Atomicbeast101/universal-control-box/3dmodels/MF-MSMF050-2.step

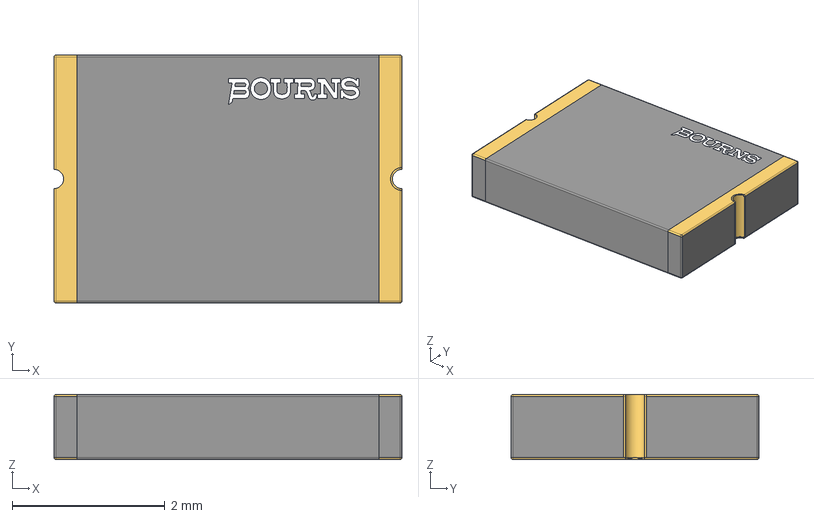
[picture p1: CAD file, 2024-06-03]
3dmodels/MF-MSMF050-2.step
4.55 x 3.24 x 0.851 mm
SDSDS
pIN eXTEND
gOLD
Bourns Logo-LAPTOP-NQA1DCQ3
