Atomicbeast101/universal-control-box/enclosure-model/Display Bracket.stl

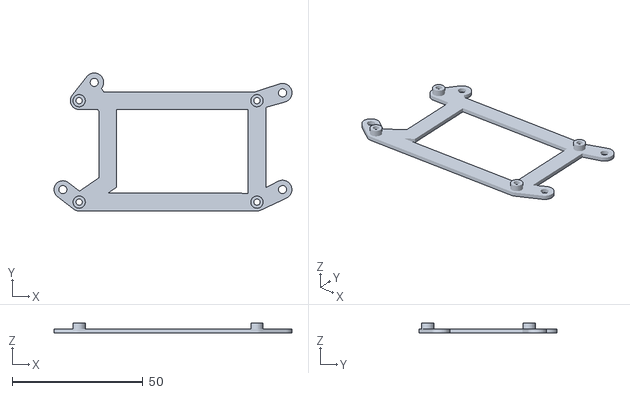
[picture p2: CAD file, 2024-06-03]
enclosure-model/Display Bracket.stl
91.0 x 52.8 x 4.00
