Atomicbeast101/universal-control-box/Universal Control Box.step

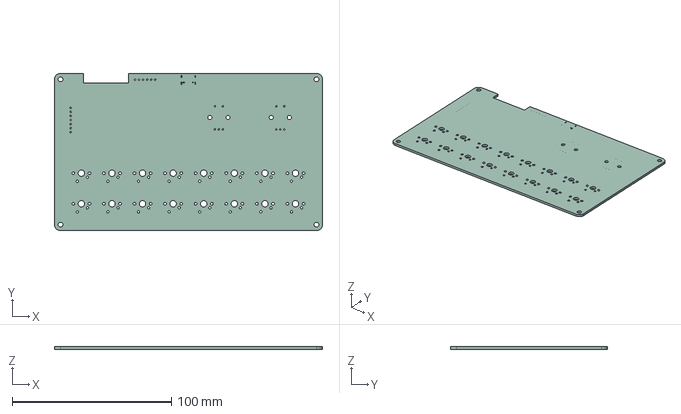
[picture p3: CAD file, 2024-06-03]
Universal Control Box.step
168.2 x 98.8 x 1.61 mm
