Atomicbeast101/universal-control-box/3dmodels/USB_type_C_smd_12p.stp

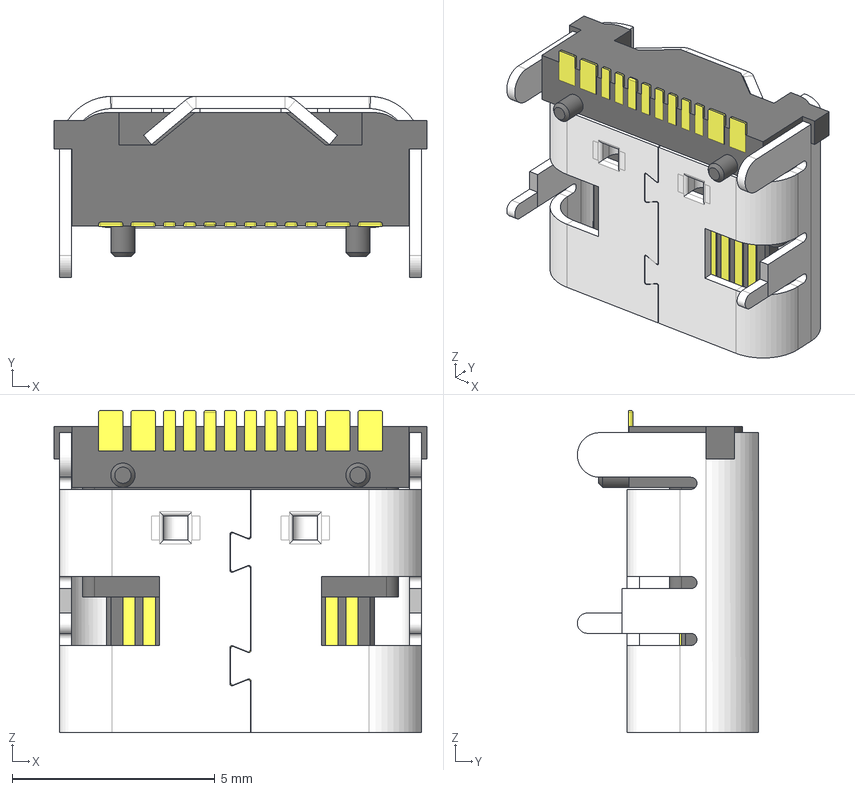
[picture p4: CAD file, 2024-06-03]
3dmodels/USB_type_C_smd_12p.stp
9.20 x 4.47 x 7.95 mm
