Atomicbeast101/universal-control-box/enclosure-model/Top.stl

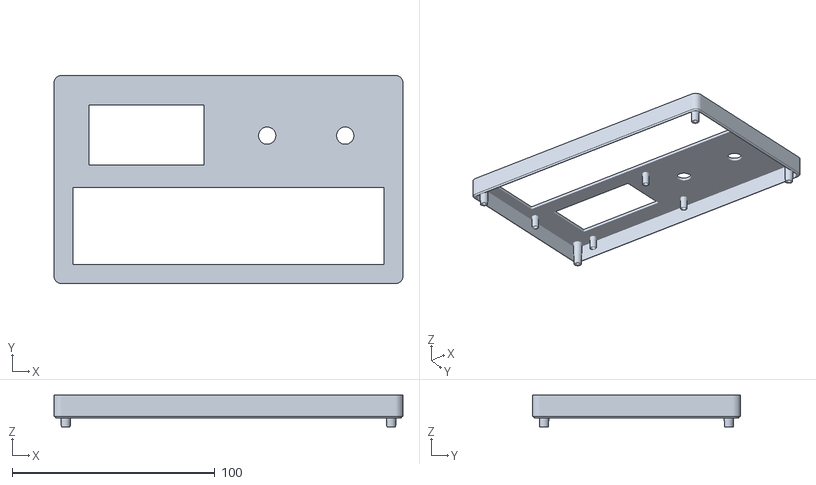
[picture p5: CAD file, 2024-06-03]
enclosure-model/Top.stl
172.2 x 102.8 x 15.7
