Atomicbeast101/universal-control-box/3dmodels/SSD1309_OLED.step

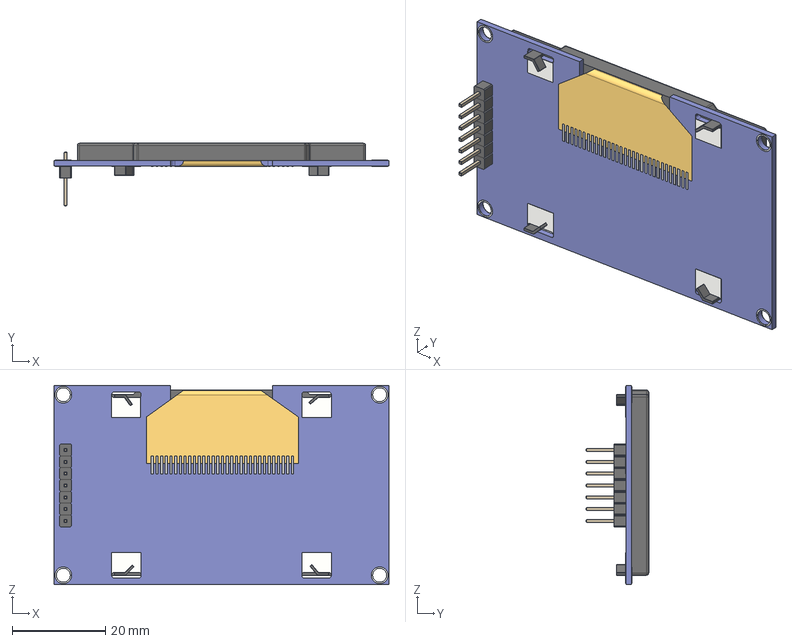
[picture p6: CAD file, 2024-06-03]
3dmodels/SSD1309_OLED.step
72.0 x 13.4 x 42.8 mm
screen
cable
PLS-7 v2
