Atomicbeast101/universal-control-box/enclosure-model/Bottom.stl

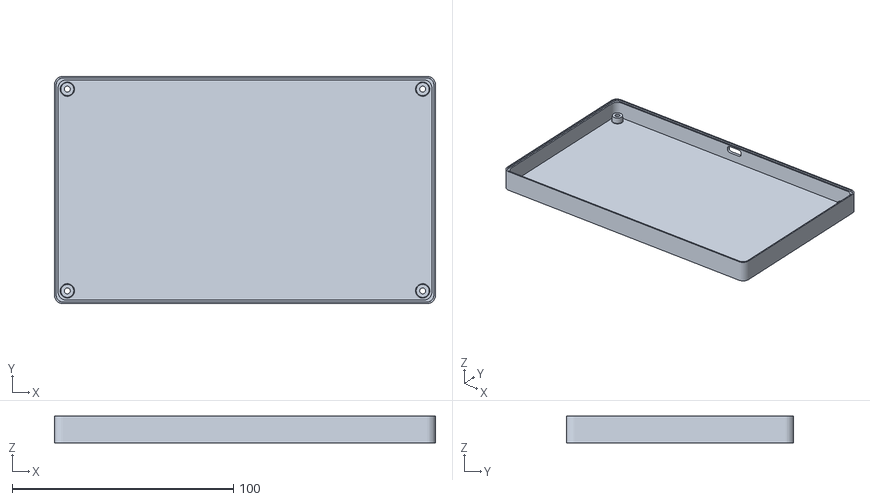
[picture p7: CAD file, 2024-06-03]
enclosure-model/Bottom.stl
172.2 x 102.8 x 12.0
