Atomicbeast101/universal-control-box/3dmodels/WS2812B-2020.stp

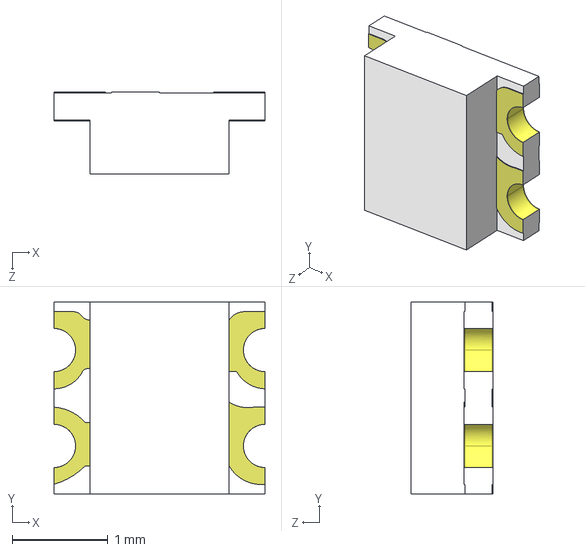
[picture p8: CAD file, 2024-06-03]
3dmodels/WS2812B-2020.stp
2.20 x 2.00 x 0.85 mm
