Atomicbeast101/universal-control-box/3dmodels/TexasInstruments_PFC8575DBR.stp

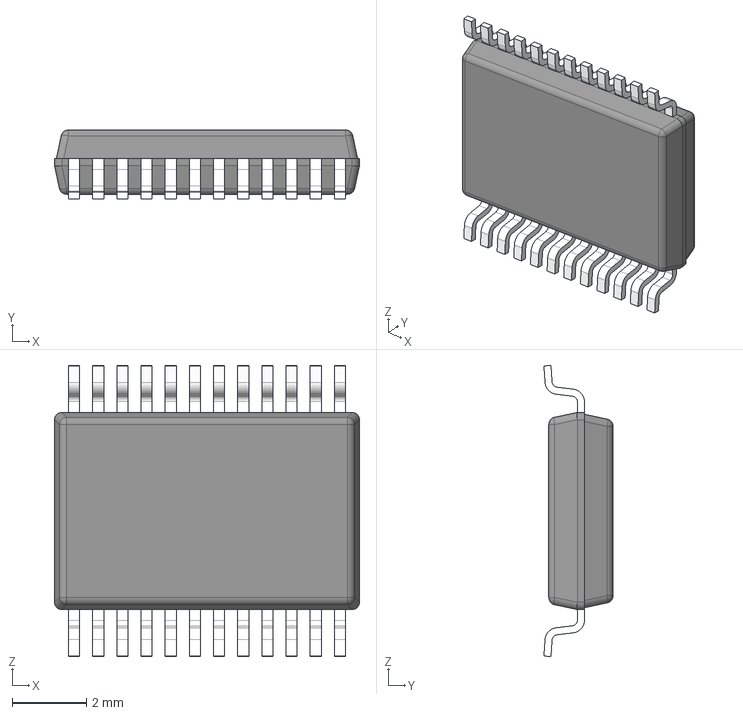
[picture p9: CAD file, 2024-06-03]
3dmodels/TexasInstruments_PFC8575DBR.stp
8.20 x 1.86 x 7.83 mm
BODY_MSA24
LEAD_MSA24 x 24
