Atomicbeast101/universal-control-box/3dmodels/SW_Cherry_MX_PCB.stp

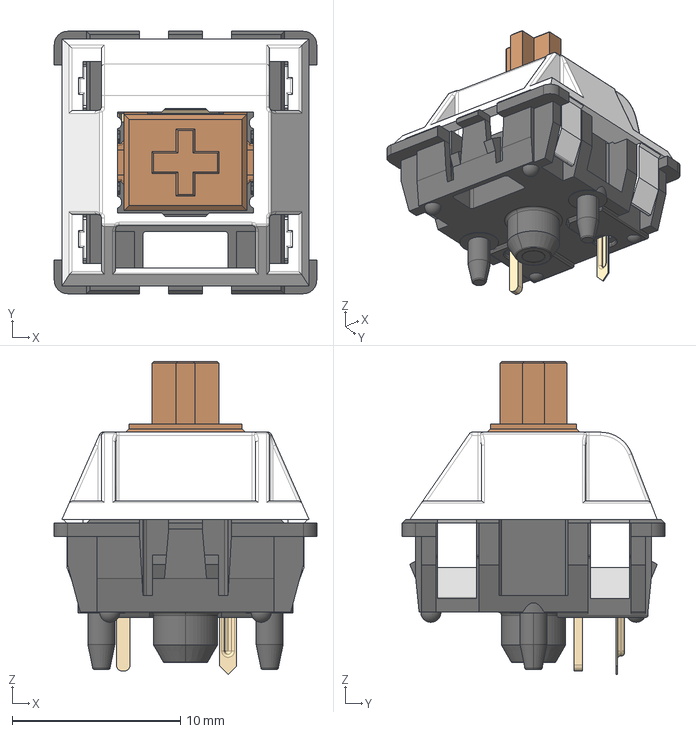
[picture p10: CAD file, 2024-06-03]
3dmodels/SW_Cherry_MX_PCB.stp
15.6 x 15.6 x 18.6 mm
