Atomicbeast101/universal-control-box/3dmodels/Bourns_PEC11H-4025F-S0016.step

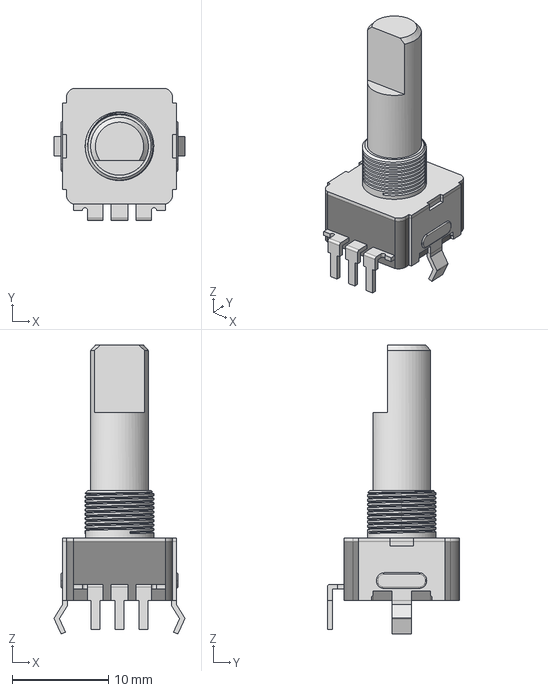
[picture p11: CAD file, 2024-06-03]
3dmodels/Bourns_PEC11H-4025F-S0016.step
13.6 x 13.7 x 30.0 mm
