Atomicbeast101/universal-control-box/Universal Control Box.kicad_pcb

## KiCad design Universal Control Box.kicad_pcb (2024-06-03)

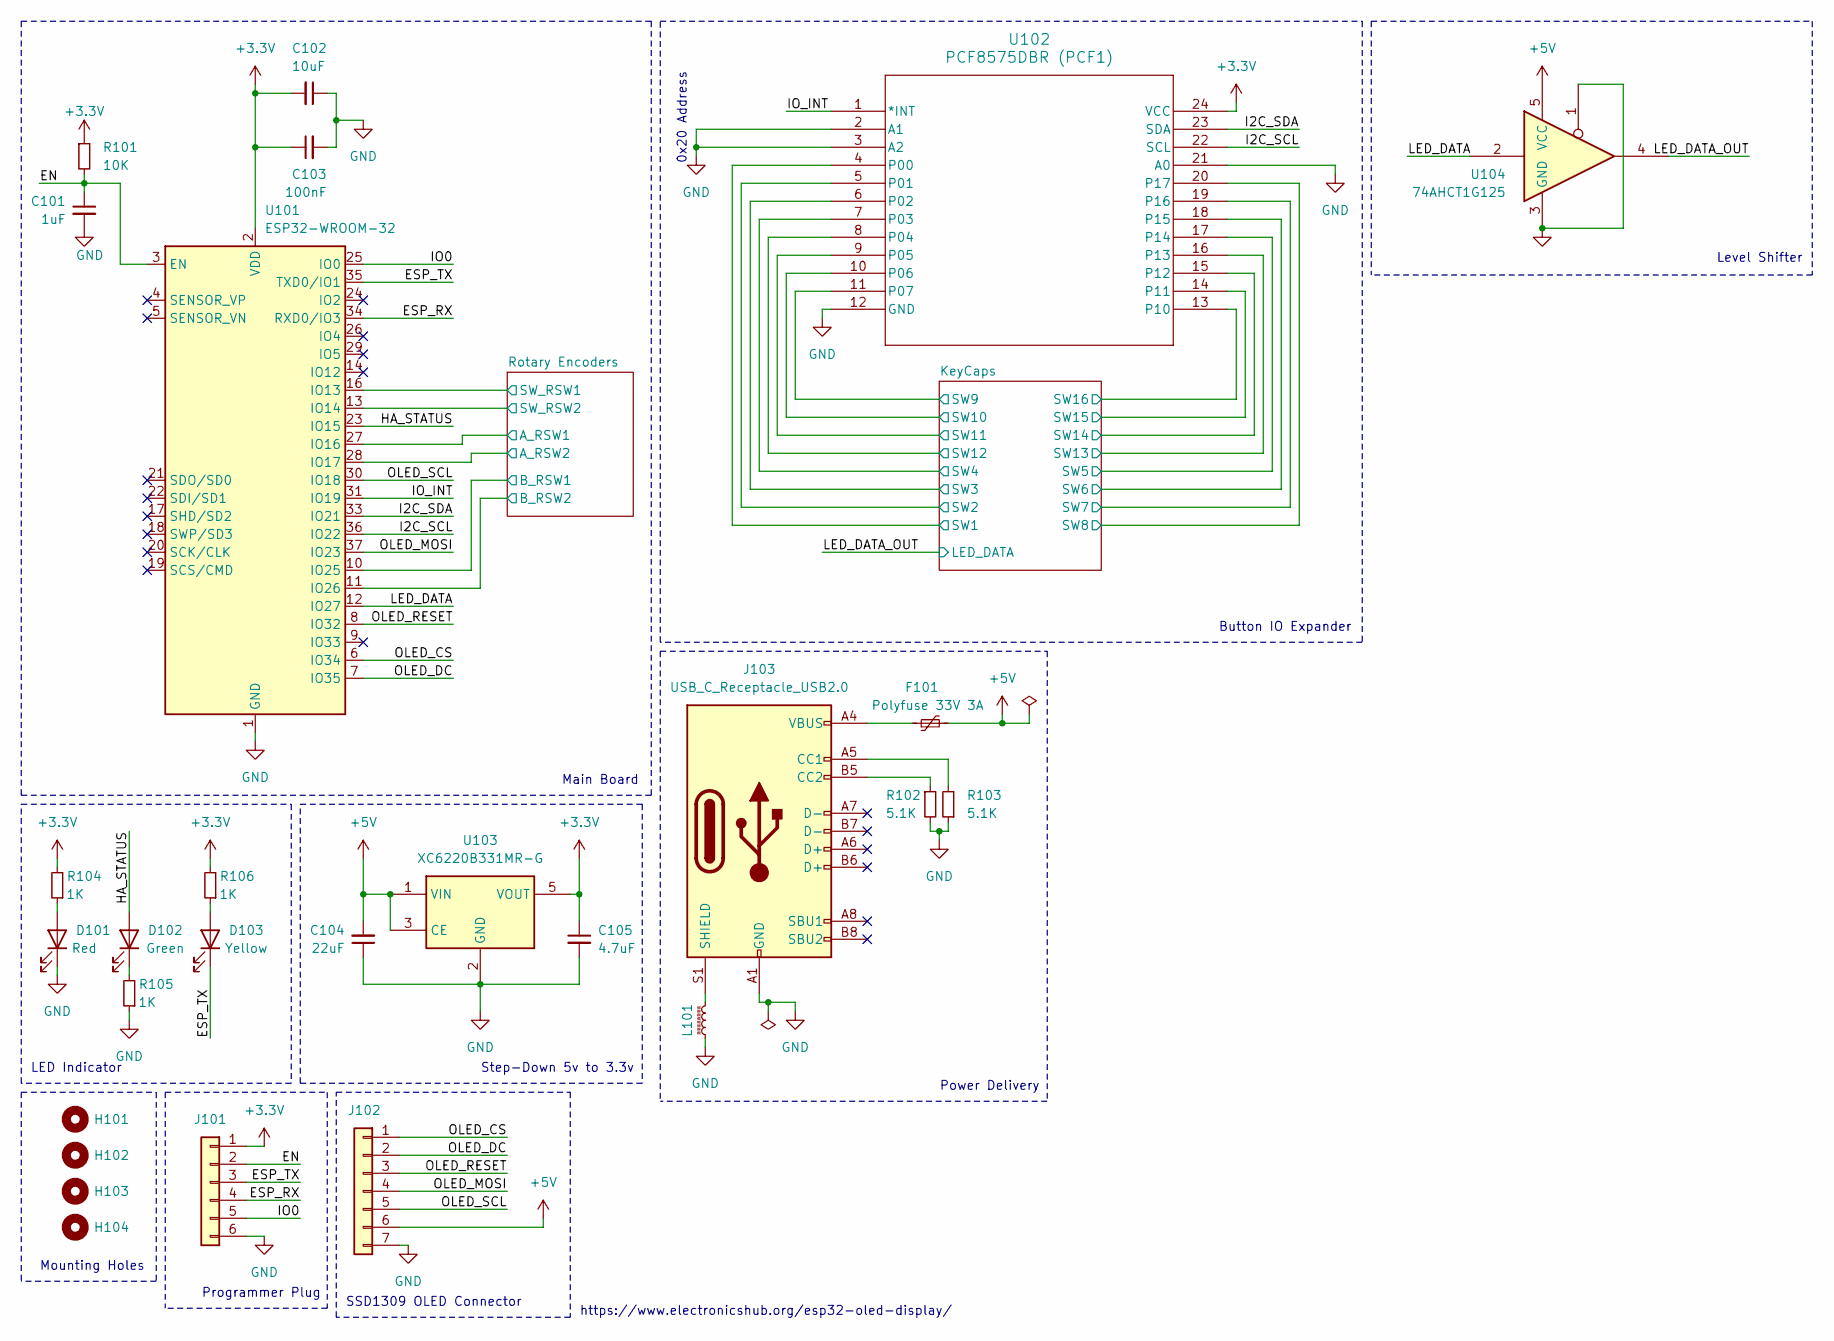
[picture p12: schematic Universal Control Box.kicad_sch]

Parts:
C101: 1uF; C_0603_1608Metric; LCSC C15849
C102: 10uF; C_0603_1608Metric; LCSC C96446
C103: 100nF; C_0603_1608Metric; LCSC C14663
C104: 22uF; C_0603_1608Metric; LCSC C59461
C105: 4.7uF; C_0603_1608Metric; LCSC C19666
D101: Red; LED_0805_2012Metric; LCSC C84256
D102: Green; LED_0805_2012Metric; LCSC C2297
D103: Yellow; LED_0805_2012Metric; LCSC C2296
F101: Polyfuse 33V 3A; Fuse_1812_4532Metric; LCSC C883154
H101, H102, H103, H104: MountingHole; MountingHole_3mm
J101: Conn_01x06; PinSocket_1x06_P2.54mm_Vertical
J102: Conn_01x07; PinSocket_1x07_P2.54mm_Vertical_SSD1309
J103: USB_C_Receptacle_USB2.0; USB_C_Receptable_918-418K2023S40001; LCSC C2982555
L101: L_Ferrite_Small; L_0603_1608Metric; LCSC C62708
R101: 10K; R_0603_1608Metric; LCSC C25804
R102, R103: 5.1K; R_0603_1608Metric; LCSC C25804
R104, R105, R106: 1K; R_0603_1608Metric; LCSC C21190
U101: ESP32-WROOM-32; LCSC C473012
U102: PCF8575DBR (PCF1); TexasInstruments_PCF8575DBR; LCSC C2863388
U103: XC6220B331MR-G; SOT-23-5; LCSC C86534
U104: 74AHCT1G125; SOT-23-5; LCSC C7484

Connections:
+3.3V: C102.2, C103.1, C105.1, J101.1, R101.1, R104.2, R106.2, U101.2 (VDD), U102.24 (VCC), U103.5 (VOUT); also elsewhere on the board
+5V: C104.2, F101.2, J102.6, U103.1 (VIN), U103.3 (CE), U104.5 (VCC); also elsewhere on the board
/EN: C101.1, J101.2, R101.2, U101.3 (EN)
/ESP_RX: J101.4, U101.34 (RXD0/IO3)
/ESP_TX: D103.1 (K), J101.3, U101.35 (TXD0/IO1)
/HA_STATUS: D102.2 (A), U101.23 (IO15)
/I2C_SCL: U101.36 (IO22), U102.22 (SCL)
/I2C_SDA: U101.33 (IO21), U102.23 (SDA)
/IO0: J101.5, U101.25 (IO0)
/IO_INT: U101.31 (IO19), U102.1 (*INT)
/KeyCaps/SW1: U102.4 (P00); also elsewhere on the board
/KeyCaps/SW2: U102.5 (P01); also elsewhere on the board
/KeyCaps/SW3: U102.6 (P02); also elsewhere on the board
/KeyCaps/SW4: U102.7 (P03); also elsewhere on the board
/KeyCaps/SW5: U102.17 (P14); also elsewhere on the board
/KeyCaps/SW6: U102.18 (P15); also elsewhere on the board
/KeyCaps/SW7: U102.19 (P16); also elsewhere on the board
/KeyCaps/SW8: U102.20 (P17); also elsewhere on the board
/KeyCaps/SW9: U102.11 (P07); also elsewhere on the board
/KeyCaps/SW10: U102.10 (P06); also elsewhere on the board
/KeyCaps/SW11: U102.9 (P05); also elsewhere on the board
/KeyCaps/SW12: U102.8 (P04); also elsewhere on the board
/KeyCaps/SW13: U102.16 (P13); also elsewhere on the board
/KeyCaps/SW14: U102.15 (P12); also elsewhere on the board
/KeyCaps/SW15: U102.14 (P11); also elsewhere on the board
/KeyCaps/SW16: U102.13 (P10); also elsewhere on the board
/LED_DATA: U101.12 (IO27), U104.2
/LED_DATA_OUT: U104.4; also elsewhere on the board
/OLED_CS: J102.1, U101.6 (IO34)
/OLED_DC: J102.2, U101.7 (IO35)
/OLED_MOSI: J102.4, U101.37 (IO23)
/OLED_RESET: J102.3, U101.8 (IO32)
/OLED_SCL: J102.5, U101.30 (IO18)
/Rotary Encoders/A_RSW1: U101.27 (IO16); also elsewhere on the board
/Rotary Encoders/A_RSW2: U101.28 (IO17); also elsewhere on the board
/Rotary Encoders/B_RSW1: U101.10 (IO25); also elsewhere on the board
/Rotary Encoders/B_RSW2: U101.11 (IO26); also elsewhere on the board
/Rotary Encoders/SW_RSW1: U101.16 (IO13); also elsewhere on the board
/Rotary Encoders/SW_RSW2: U101.13 (IO14); also elsewhere on the board
GND: C101.2, C102.1, C103.2, C104.1, C105.2, D101.1 (K), J101.6, J102.7, J103.A1 (GND), J103.A12 (GND), J103.B1 (GND), J103.B12 (GND), L101.1, R102.2, R103.1, R105.1, U101.1 (GND), U101.15 (GND), U101.38 (GND), U101.39 (GND), U102.2 (A1), U102.3 (A2), U102.12 (GND), U102.21 (A0), U103.2 (GND), U104.1, U104.3 (GND); also elsewhere on the board
unnamed: D101.2 (A), R104.1
unnamed: D102.1 (K), R105.2
unnamed: D103.2 (A), R106.1
unnamed: F101.1, J103.A4 (VBUS), J103.A9 (VBUS), J103.B4 (VBUS), J103.B9 (VBUS)
unnamed: J103.A5 (CC1), R103.2
unnamed: J103.B5 (CC2), R102.1
unnamed: J103.S1 (SHIELD), L101.2

Notes on the sheet:
Mounting Holes
Power Delivery
Button IO Expander
https://www.electronicshub.org/esp32-oled-display/
LED Indicator
0x20 Address
Programmer Plug
SSD1309 OLED Connector
Step-Down 5v to 3.3v
Level Shifter
Main Board

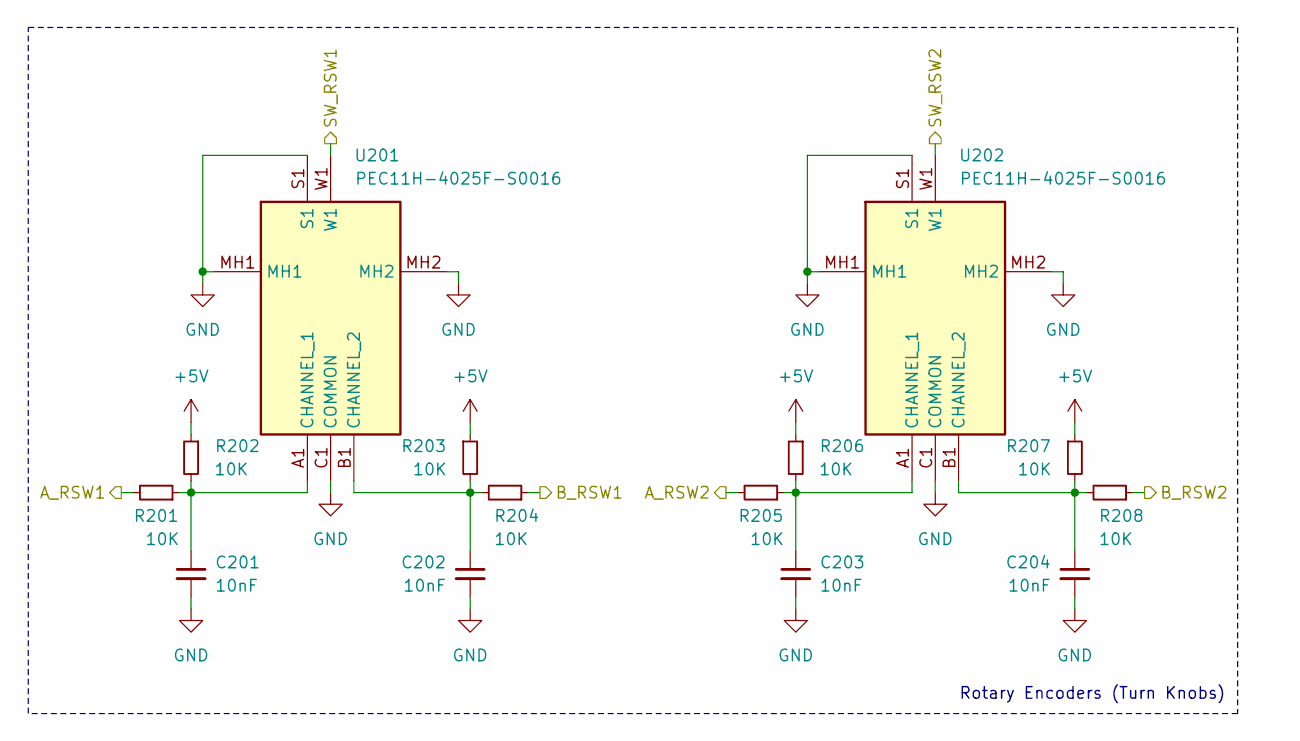
[picture p13: schematic RotaryEncoders.kicad_sch]

Parts:
C201, C202, C203, C204: 10nF; C_0603_1608Metric; LCSC C57112
R201, R202, R203, R204, R205, R206, R207, R208: 10K; R_0603_1608Metric; LCSC C25804
U201, U202: PEC11H-4025F-S0016; PEC11H4025FS0016; Mouser Part Number 652-PEC11H4025FS0016

Connections:
+5V: R202.1, R203.1, R206.1, R207.1; also elsewhere on the board
/Rotary Encoders/A_RSW1: R201.2; also elsewhere on the board
/Rotary Encoders/A_RSW2: R205.2; also elsewhere on the board
/Rotary Encoders/B_RSW1: R204.1; also elsewhere on the board
/Rotary Encoders/B_RSW2: R208.1; also elsewhere on the board
/Rotary Encoders/SW_RSW1: U201.W1; also elsewhere on the board
/Rotary Encoders/SW_RSW2: U202.W1; also elsewhere on the board
GND: C201.2, C202.2, C203.2, C204.2, U201.C1 (COMMON), U201.MH1, U201.MH2, U201.S1, U202.C1 (COMMON), U202.MH1, U202.MH2, U202.S1; also elsewhere on the board
unnamed: C201.1, R201.1, R202.2, U201.A1 (CHANNEL_1)
unnamed: C202.1, R203.2, R204.2, U201.B1 (CHANNEL_2)
unnamed: C203.1, R205.1, R206.2, U202.A1 (CHANNEL_1)
unnamed: C204.1, R207.2, R208.2, U202.B1 (CHANNEL_2)

Notes on the sheet:
Rotary Encoders (Turn Knobs)

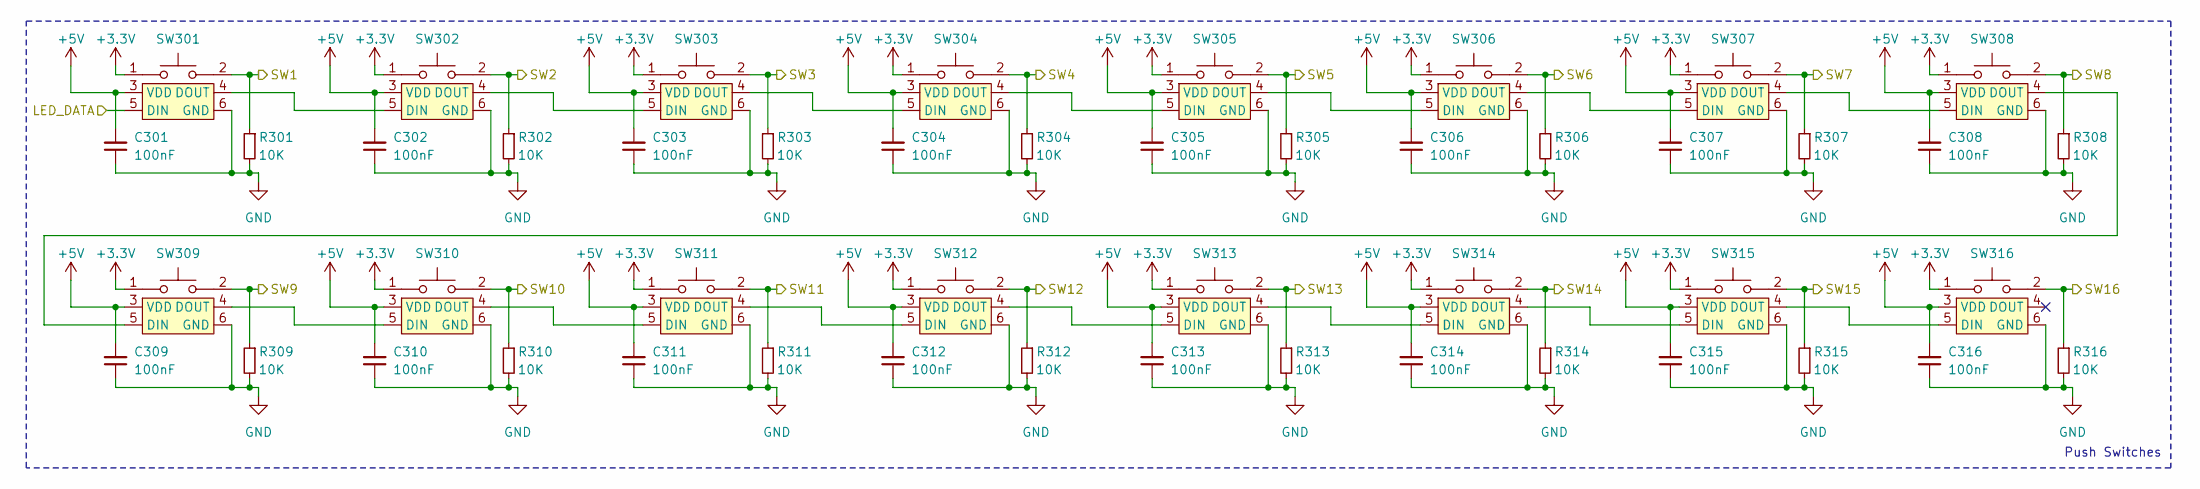
[picture p14: schematic KeyCaps.kicad_sch]

Parts:
C301, C302, C303, C304, C305, C306, C307, C308, C309, C310, C311, C312, C313, C314, C315, C316: 100nF; C_0603_1608Metric; LCSC C14663
R301, R302, R303, R304, R305, R306, R307, R308, R309, R310, R311, R312, R313, R314, R315, R316: 10K; R_0603_1608Metric; LCSC C25804
SW301, SW302, SW303, SW304, SW305, SW306, SW307, SW308, SW309, SW310, SW311, SW312, SW313, SW314, SW315, SW316: CherryMX_1.00u_PCB_WS2812B-2020; LCSC C965555

Connections:
+3.3V: SW301.1, SW302.1, SW303.1, SW304.1, SW305.1, SW306.1, SW307.1, SW308.1, SW309.1, SW310.1, SW311.1, SW312.1, SW313.1, SW314.1, SW315.1, SW316.1; also elsewhere on the board
+5V: C301.2, C302.2, C303.2, C304.2, C305.2, C306.2, C307.2, C308.2, C309.2, C310.2, C311.2, C312.2, C313.2, C314.2, C315.2, C316.2, SW301.3 (VDD), SW302.3 (VDD), SW303.3 (VDD), SW304.3 (VDD), SW305.3 (VDD), SW306.3 (VDD), SW307.3 (VDD), SW308.3 (VDD), SW309.3 (VDD), SW310.3 (VDD), SW311.3 (VDD), SW312.3 (VDD), SW313.3 (VDD), SW314.3 (VDD), SW315.3 (VDD), SW316.3 (VDD); also elsewhere on the board
/KeyCaps/SW1: R301.1, SW301.2; also elsewhere on the board
/KeyCaps/SW2: R302.1, SW302.2; also elsewhere on the board
/KeyCaps/SW3: R303.1, SW303.2; also elsewhere on the board
/KeyCaps/SW4: R304.1, SW304.2; also elsewhere on the board
/KeyCaps/SW5: R305.1, SW305.2; also elsewhere on the board
/KeyCaps/SW6: R306.1, SW306.2; also elsewhere on the board
/KeyCaps/SW7: R307.1, SW307.2; also elsewhere on the board
/KeyCaps/SW8: R308.1, SW308.2; also elsewhere on the board
/KeyCaps/SW9: R309.1, SW309.2; also elsewhere on the board
/KeyCaps/SW10: R310.1, SW310.2; also elsewhere on the board
/KeyCaps/SW11: R311.1, SW311.2; also elsewhere on the board
/KeyCaps/SW12: R312.1, SW312.2; also elsewhere on the board
/KeyCaps/SW13: R313.1, SW313.2; also elsewhere on the board
/KeyCaps/SW14: R314.1, SW314.2; also elsewhere on the board
/KeyCaps/SW15: R315.1, SW315.2; also elsewhere on the board
/KeyCaps/SW16: R316.1, SW316.2; also elsewhere on the board
/LED_DATA_OUT: SW301.5 (DIN); also elsewhere on the board
GND: C301.1, C302.1, C303.1, C304.1, C305.1, C306.1, C307.1, C308.1, C309.1, C310.1, C311.1, C312.1, C313.1, C314.1, C315.1, C316.1, R301.2, R302.2, R303.2, R304.2, R305.2, R306.2, R307.2, R308.2, R309.2, R310.2, R311.2, R312.2, R313.2, R314.2, R315.2, R316.2, SW301.6 (GND), SW302.6 (GND), SW303.6 (GND), SW304.6 (GND), SW305.6 (GND), SW306.6 (GND), SW307.6 (GND), SW308.6 (GND), SW309.6 (GND), SW310.6 (GND), SW311.6 (GND), SW312.6 (GND), SW313.6 (GND), SW314.6 (GND), SW315.6 (GND), SW316.6 (GND); also elsewhere on the board
unnamed: SW301.4 (DOUT), SW302.5 (DIN)
unnamed: SW302.4 (DOUT), SW303.5 (DIN)
unnamed: SW303.4 (DOUT), SW304.5 (DIN)
unnamed: SW304.4 (DOUT), SW305.5 (DIN)
unnamed: SW305.4 (DOUT), SW306.5 (DIN)
unnamed: SW306.4 (DOUT), SW307.5 (DIN)
unnamed: SW307.4 (DOUT), SW308.5 (DIN)
unnamed: SW308.4 (DOUT), SW309.5 (DIN)
unnamed: SW309.4 (DOUT), SW310.5 (DIN)
unnamed: SW310.4 (DOUT), SW311.5 (DIN)
unnamed: SW311.4 (DOUT), SW312.5 (DIN)
unnamed: SW312.4 (DOUT), SW313.5 (DIN)
unnamed: SW313.4 (DOUT), SW314.5 (DIN)
unnamed: SW314.4 (DOUT), SW315.5 (DIN)
unnamed: SW315.4 (DOUT), SW316.5 (DIN)

Notes on the sheet:
Push Switches

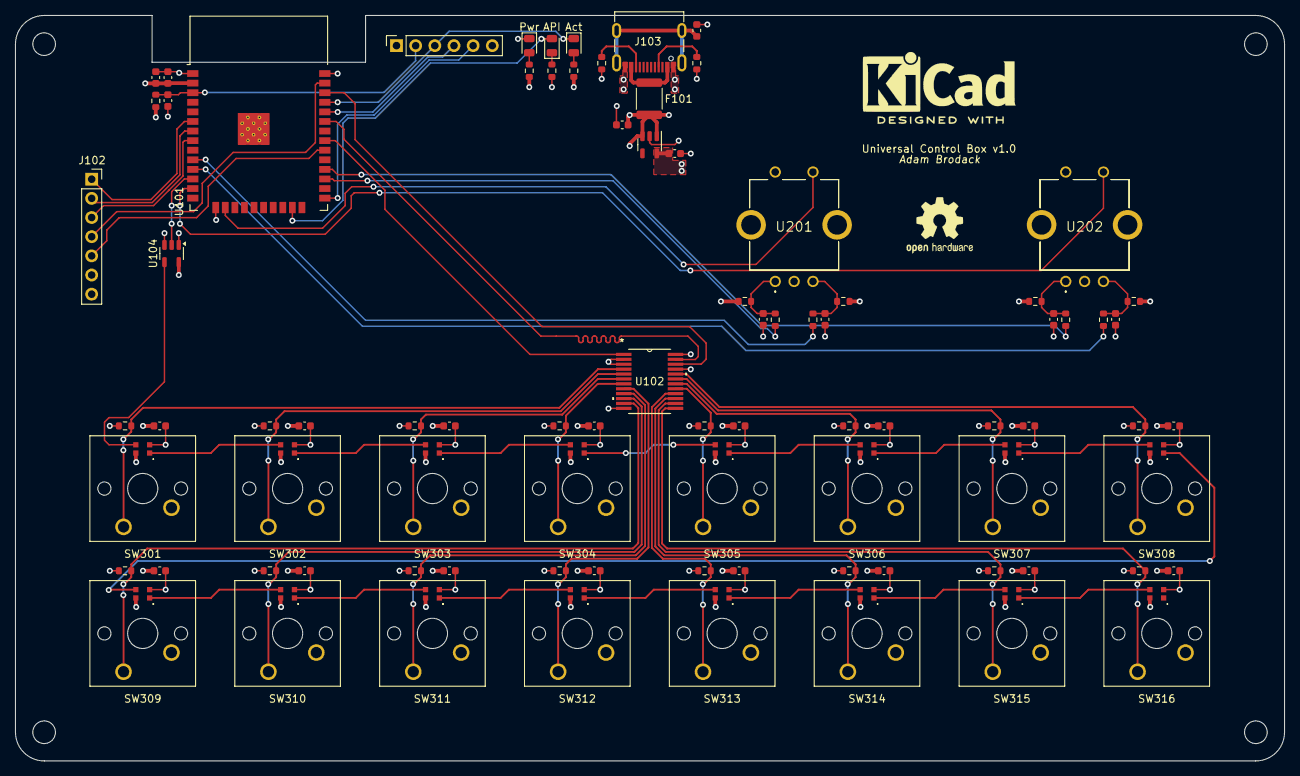
[picture p15: board Universal Control Box.kicad_pcb from above]

Board: 4 copper layers, 168.2 x 98.8 mm, 89 parts (0 on the bottom side), 66 nets.
