Atomicbeast101/universal-control-box/(commit log)

2024-01-17 Major changes
    [KeyCaps.kicad_sch, RotaryEncoders.kicad_sch, Universal Control Box.kicad_pcb, Universal Control Box.kicad_sch]
2024-01-19 add design review comments
    [KeyCaps.kicad_sch, Universal Control Box.kicad_pcb, Universal Control Box.kicad_sch]
2024-01-20 Fixed wiring for buttons
    [KeyCaps.kicad_sch]
2024-01-26 Made changes based on Josh's comments & switched to Switched to WS2812B-2020
    [KeyCap RGB.kicad_sch, KeyCaps.kicad_sch, RotaryEncoders.kicad_sch, Universal Control Box.kicad_sch, encoders.kicad_sch]
2024-01-27 Fixed LED Schematic & added 2 more LEDs
    [KeyCaps.kicad_sch, Universal Control Box.kicad_pcb, Universal Control Box.kicad_sch]
2024-01-27 Added missing resistor for Green LED
    [Universal Control Box.kicad_pcb, Universal Control Box.kicad_sch]
2024-01-27 Updated PCB layout (no wires yet)
    [KeyCaps.kicad_sch, Universal Control Box.kicad_pcb]
2024-03-14 Added GND & other stuff
    [Universal Control Box.kicad_pcb, Universal Control Box.kicad_sch]
2024-03-16 Added remaining traces
    [Universal Control Box.kicad_pcb]
2024-04-26 Updated designs to meet feedback
    [KeyCaps.kicad_sch, RotaryEncoders.kicad_sch, Universal Control Box.kicad_pcb, Universal Control Box.kicad_sch]
2024-04-27 Some improvements & added labeling
    [Universal Control Box-CuBottom.gbr, Universal Control Box-CuIn1.gbr, Universal Control Box-CuIn2.gbr, Universal Control Box-CuTop.gbr, Universal Control Box-EdgeCuts.gbr, Universal Control Box-MaskBottom.gbr, Universal Control Box-MaskTop.gbr, Universal Control Box-NPTH.drl]
2024-04-28 Included symbols/footprints/3dmodels to repo
    [KeyCaps.kicad_sch, MF-MSMF050-2.step, SSD1309_OLED.step, TexasInstruments_PFC8575DBR.stp, USB_type_C_smd_12p.stp, Universal Control Box.kicad_sch]
2024-04-28 Fixed library links
    [Bourns_PEC11H-4025F-S0016.step, RotaryEncoders.kicad_sch, SW_Cherry_MX_PCB.stp, Universal Control Box.kicad_pcb, WS2812B-2020.stp]
2024-04-28 add keycap model
    [cherry-mx-keycap.step]
2024-04-28 add pcb 3d model
2024-04-28 update design
    [Universal Control Box.kicad_pcb, Universal Control Box.kicad_sch]
2024-05-05 Updated keycap & added missing logos
    [Universal Control Box.kicad_pcb, cherry-mx-keycap.step]
2024-05-05 Fixed trace route length for I2C
    [Universal Control Box.kicad_pcb]
2024-05-06 Remove jlcpcb files
    [Universal Control Box-CuBottom.gbr, Universal Control Box-CuIn1.gbr, Universal Control Box-CuIn2.gbr, Universal Control Box-CuTop.gbr, Universal Control Box-EdgeCuts.gbr, Universal Control Box-MaskBottom.gbr, Universal Control Box-MaskTop.gbr, Universal Control Box-NPTH.drl]
2024-05-07 Fix logo stuff
    [KeyCaps.kicad_sch, RotaryEncoders.kicad_sch, Universal Control Box.kicad_pcb, Universal Control Box.kicad_sch]
2024-05-19 Fixed origin position for exported .step file
    [Universal Control Box.kicad_pcb]
2024-05-21 add nclosure models
    [Bottom.stl, Display Bracket.stl, Top.stl]
2024-06-04 Fixed wiring for OLED display, push button for rotary & added chips for programming via USB C
    [RotaryEncoders.kicad_sch, Universal Control Box.kicad_sch]
2024-06-05 Organized overview a little bit
    [Universal Control Box.kicad_sch]
2024-06-05 A few more improvements
    [RotaryEncoders.kicad_sch]
2024-06-05 Even more layout improvements
    [Universal Control Box.kicad_sch]
2024-06-08 added comments
    [Universal Control Box.kicad_sch]
